Lemi0002/PIC32ETH_EL/README.md

# PIC32ETH_EL
Repository for PIC32ETH electronics. This board is a simple development board
to investigate what it actually takes to integrate ethernet connectivity into
its own PCB design.

## Tool configuration
The following software versions were used:

* Altium Designer: v20.1.1
