Lemi0002/PIC32ETH_EL/PIC32ETH/Project_Outputs/Bill_Of_Materials/Bill_Of_Materials.xlsx

Designator | Comment | Part Number | Description | Package | Quantity
C1, C2, C3, C4, C5, C6, C7, C8, C9, C10, C11, C12, C24, C25, C26, C27, C29, C33, C34, C35, C39, C42, C44, C49 | 100nF | C0805C104K5RACTU | C CERAMIC 100nF 50V 10% 2012 | 2012 | 24
C13, C14, C15, C19, C20, C21, C22, C28 | 10nF | C0805C103K5RACTU | C CERAMIC 10nF 50V 10% 2012 | 2012 | 8
C16, C18, C36, C37, C47, C48 | 1uF | C0805C105K5RACTU | C CERAMIC 1uF 50V 10% 2012 | 2012 | 6
C17, C38, C43 | 10uF | C1206C106K3RACTU | C CERAMIC 10uF 25V 10% 3216 | 3216 | 3
C23, C32 | 220nF | C0805C224K5RACTU | C CERAMIC 220nF 50V 10% 2012 | 2012 | 2
C30, C31 | 47pF | C0805C470K5GACTU | C CERAMIC 47pF 50V 10% 2012 | 2012 | 2
C40, C41, C45, C46, C50 | 22uF | C1206C226K8RAC7800 | C CERAMIC 22uF 10V 10% 3216 | 3216 | 5
C51 | 1nF | C0805C102K5RACTU | C CERAMIC 1nF 50V 10% 2012 | 2012 | 1
D1 | DRTR5V0U4S-7 | DRTR5V0U4S-7 | D TVS 5.5V 6V 200mW SOT-363 | SOT-363 | 1
D2, D3, D4, D5 | APT2012LZGCK | APT2012LZGCK | D LED GREEN CLEAR 2.65V 2mA 2012 | 2012 | 4
FB1, FB2, FB3, FB4, FB5 | 120R 100MHz | BLM31KN121SN1L | FB 120R 100MHz 6A 3216 | 3216 | 5
H1 | TSW-106-08-G-S-RA | TSW-106-08-G-S-RA | H GENERAL HEADER 6POS 1ROW 2.54mm ANGLE THT | n/a | 1
H2 | J3011G21DNL | J3011G21DNL | H RJ45 SOCKET 1PORT ANGLE SMT | n/a | 1
H3 | 897-43-005-00-100001 | 897-43-005-00-100001 | H USB SOCKET 1PORT B-MINI ANGLE SMT | n/a | 1
H4 | 76382-302LF | 76382-302LF | H GENERAL HEADER 2POS 1ROW 2.54mm ANGLE THT | n/a | 1
H5, H6 | SSW-105-01-G-D | SSW-105-01-G-D | H GENERAL SOCKET 10POS 2ROW 2.54mm VERTICAL THT | n/a | 2
H7 | TSW-103-08-G-S-RA | TSW-103-08-G-S-RA | H GENERAL HEADER 3POS 1ROW 2.54mm ANGLE THT | n/a | 1
L1, L2 | 4.7uH | LQM2HPN4R7MG0L | L CERAMIC 4.7uH 1.1A 138mR 2520 | 2520 | 2
Q1, Q2, Q3 | DMG1012UW-7 | DMG1012UW-7 | Q MOSFET N-CH 20V 1A SOT-323 | SOT-323 | 3
R1, R2, R3, R4, R5, R6, R7, R8, R9, R10, R11, R12, R13, R14, R15, R21, R22, R32, R56, R57, R58, R69 | 330R | RMCF0805FT330R | R SMT 330R 1% 125mW 2012 | 2012 | 22
R16, R17 | 4.7kR | RMCF0805FT4K70 | R SMT 4.7kR 1% 125mW 2012 | 2012 | 2
R18, R19, R20, R29, R30, R31, R39, R55, R59, R60, R61, R62, R65, R68 | 10kR | RMCF0805FT10K0 | R SMT 10kR 1% 125mW 2012 | 2012 | 14
R23, R24, R25, R26, R40, R41, R42, R45, R50, R51, R52, R53, R54 | 33R | RMCF0805FT33R0 | R SMT 33R 1% 125mW 2012 | 2012 | 13
R27, R28 | 1R | RMCF0805FT1R00 | R SMT 1R 1% 125mW 2012 | 2012 | 2
R33, R34, R44, R46, R47, R48 | 1kR | RMCF0805FT1K00 | R SMT 1kR 1% 125mW 2012 | 2012 | 6
R35, R36, R37, R38 | 49.9R | RMCF0805FT49R9 | R SMT 49.9R 1% 125mW 2012 | 2012 | 4
R43 | 18.7kR | RMCF0805FT18K7 | R SMT 18.7kR 1% 125mW 2012 | 2012 | 1
R49 | 1.91kR | RMCF0805FT1K91 | R SMT 1.91kR 1% 125mW 2012 | 2012 | 1
R63, R66 | 30R | RMCF0805FT30R0 | R SMT 30R 1% 125mW 2012 | 2012 | 2
R64 | 52.3kR | RMCF0805FT52K3 | R SMT 52.3kR 1% 125mW 2012 | 2012 | 1
R67 | 31.6kR | RMCF0805FT31K6 | R SMT 31.6kR 1% 125mW 2012 | 2012 | 1
R70 | 1.2kR | RMCF0805FT1K20 | R SMT 1.2kR 1% 125mW 2012 | 2012 | 1
S1, S2, S3 | PTS645SL50SMTR92 LFS | PTS645SL50SMTR92 LFS | S TACTILE SPST-NO 12V 50mA SMT | n/a | 3
TP1, TP2, TP3, TP4 | 5006 | 5006 | TP COMPACT BLACK THT | n/a | 4
U1 | PIC32MZ1024EFE144-I/PH | PIC32MZ1024EFE144-I/PH | U MCU 32BIT 1MB 144-TQFP | 144-TQFP | 1
U2 | ICS1894-33 | ICS1894-33 | U TRANSCEIVER RMII-ETHERNET 32-QFN | 32-QFN | 1
U3 | FT230XS-R | FT230XS-R | U TRANSCEIVER UART-USB 16-SSOP | 16-SSOP | 1
U4, U5 | TPS56339DDCR | TPS56339DDCR | U REGULATOR BUCK 0.8V TO 16V 3A SOT-23-6 | SOT-23-6 | 2
Y1 | 32.768kHz | ECS-327ATQMV-AS-TR | Y OSCILLATOR 32.768kHz CMOS SMT | n/a | 1
Y2 | 24MHz | ECS-3225MV-240-CN-TR | Y OSCILLATOR 24MHz HCMOS SMT | n/a | 1
Y3 | 50MHz | ECS-3225MV-500-BN-TR | Y OSCILLATOR 50MHz HCMOS SMT | n/a | 1
