Lemi0002/PIC32ETH_EL/PIC32ETH/Project_Outputs/Schematic_Prints/Schematic_Prints.PDF

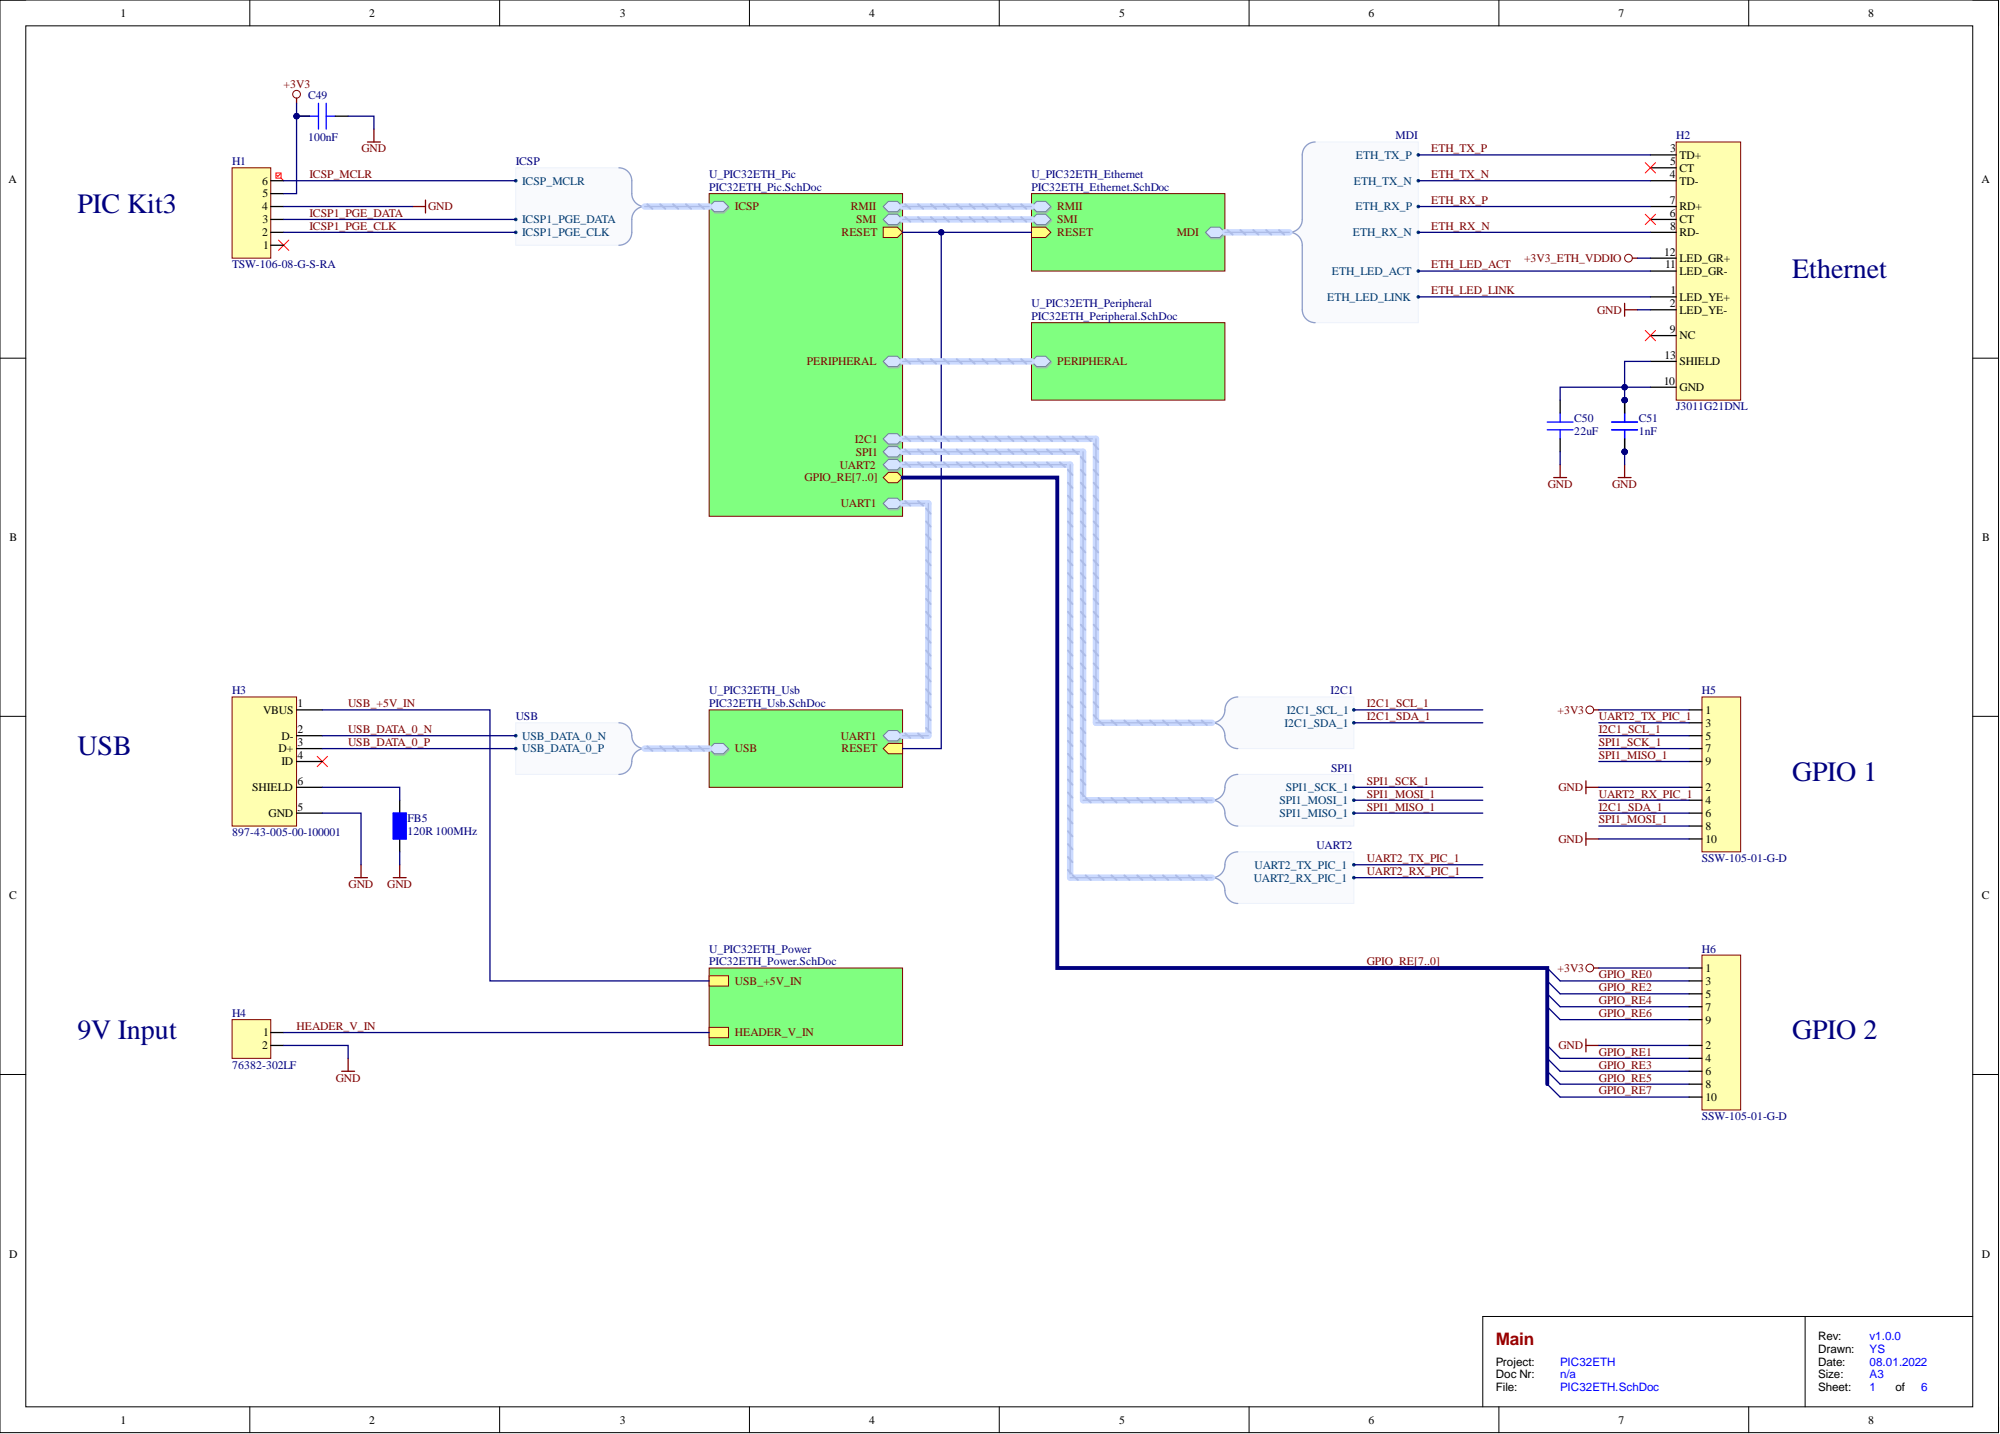
[picture p1: page 1]

Main Project: Doc Nr: File:

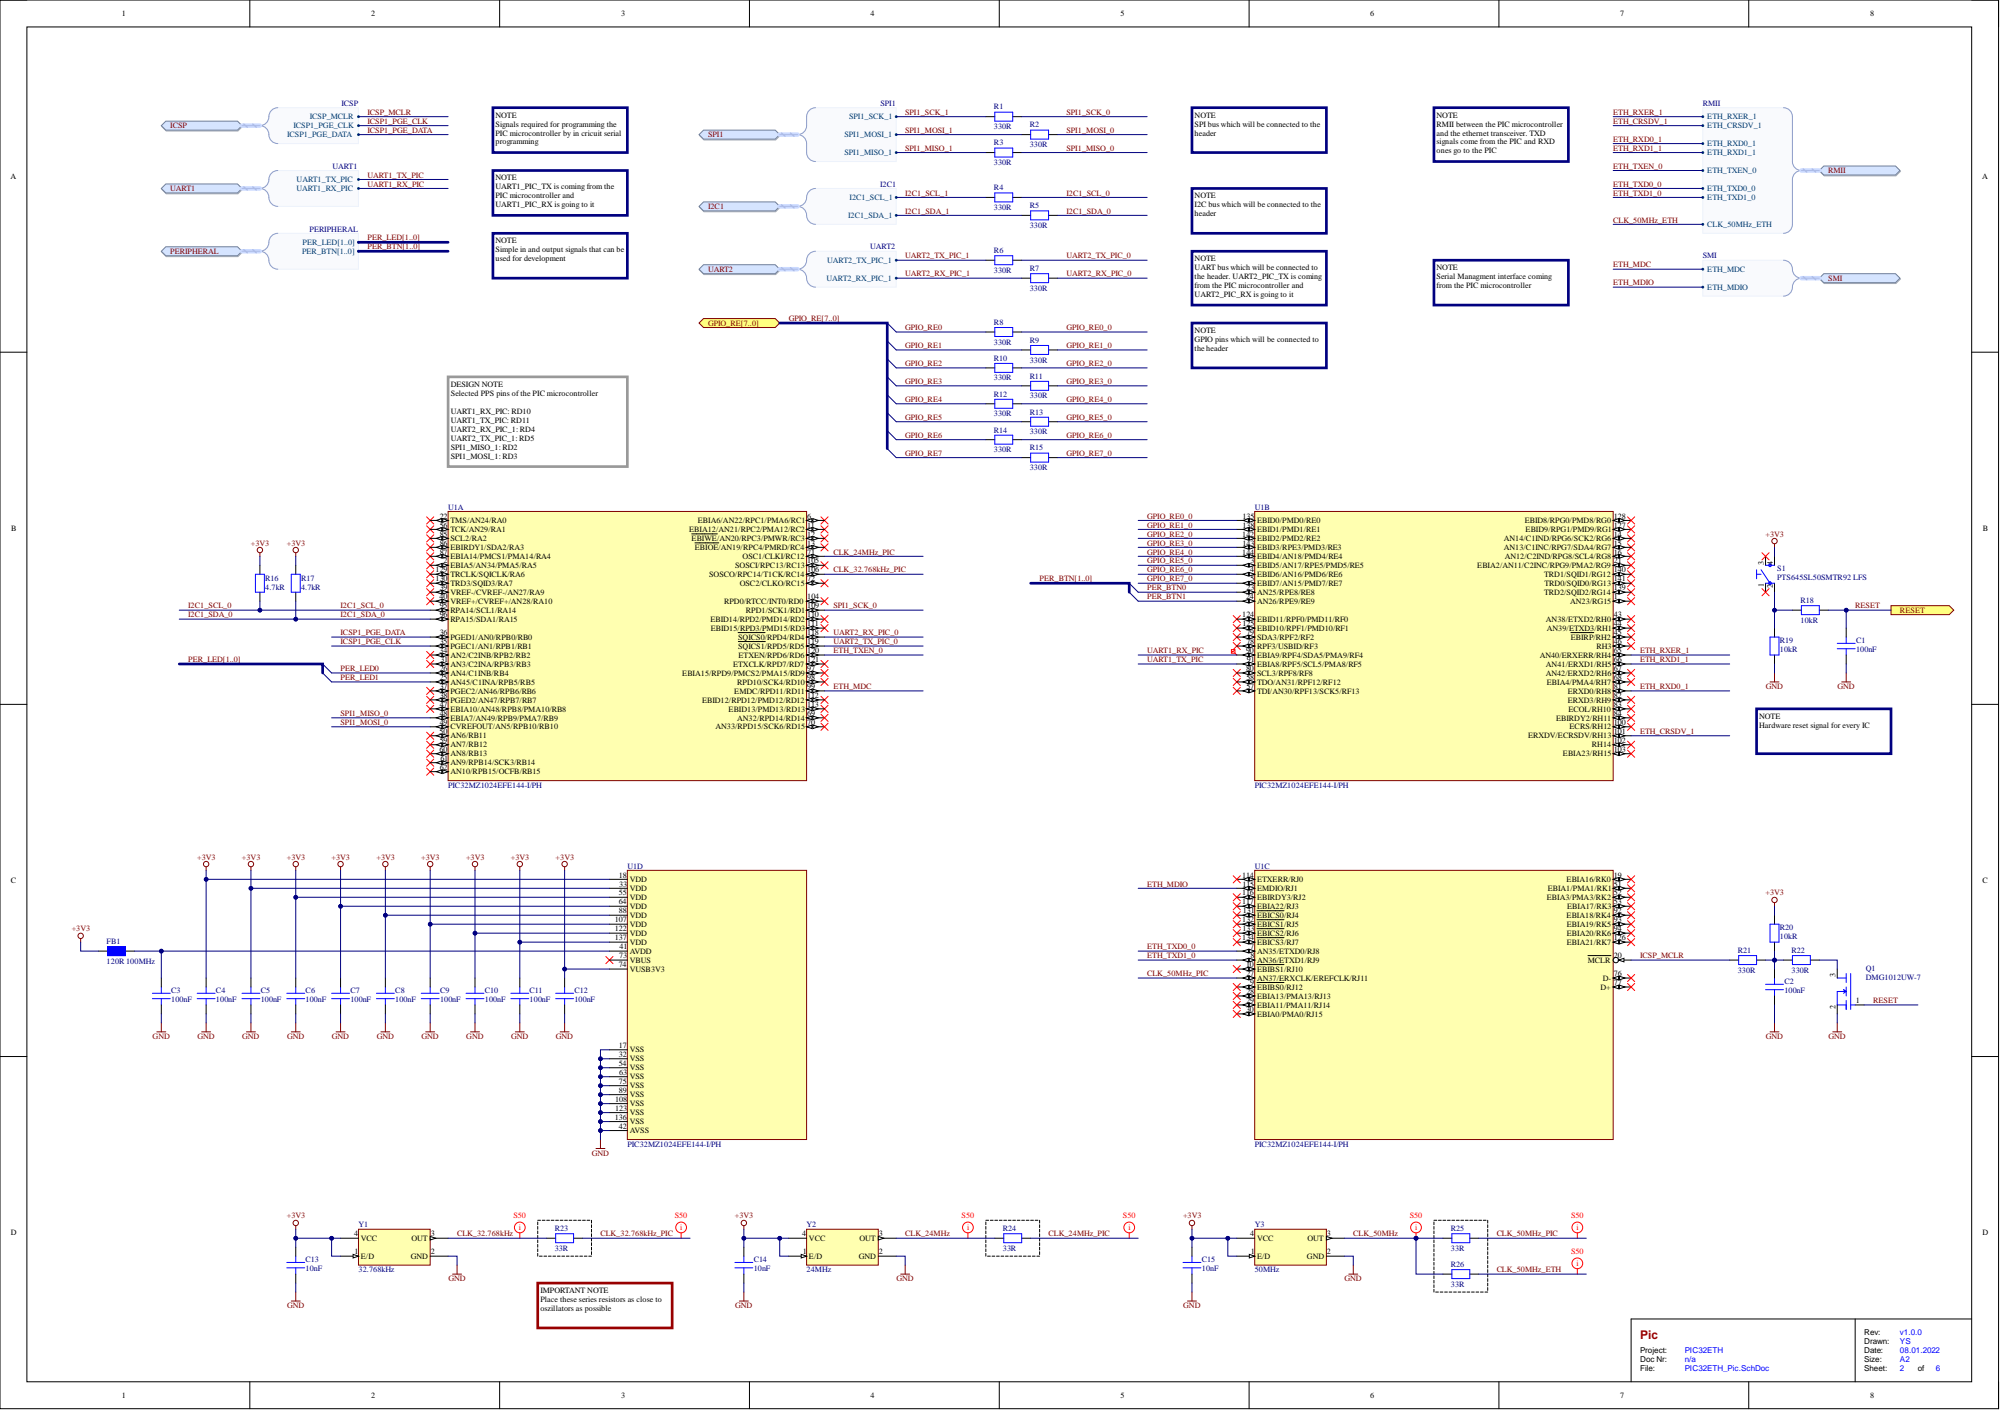
[picture p2: page 2]

NOTE
Signals required for programming the
PIC microcontroller by in cricuit serial
programming

SPI bus which will be connected to the
header

ETH_CRSDV_1 NOTE
RMII between the PIC microcontroller
and the ethernet transceiver. TXD
signals come from the PIC and RXD
ones go to the PIC

UART1_PIC_TX is coming from the
PIC microcontroller and
UART1_PIC_RX is going to it

I2C bus which will be connected to the

Simple in and output signals that can be
used for development

UART bus which will be connected to
the header. UART2_PIC_TX is coming
from the PIC microcontroller and
UART2_PIC_RX is going to it

Serial Managment interface coming

GPIO pins which will be connected to
the header

DESIGN NOTE
Selected PPS pins of the PIC microcontroller

Hardware reset signal for every IC

IMPORTANT NOTE
Place these series resistors as close to
oszillators as possible

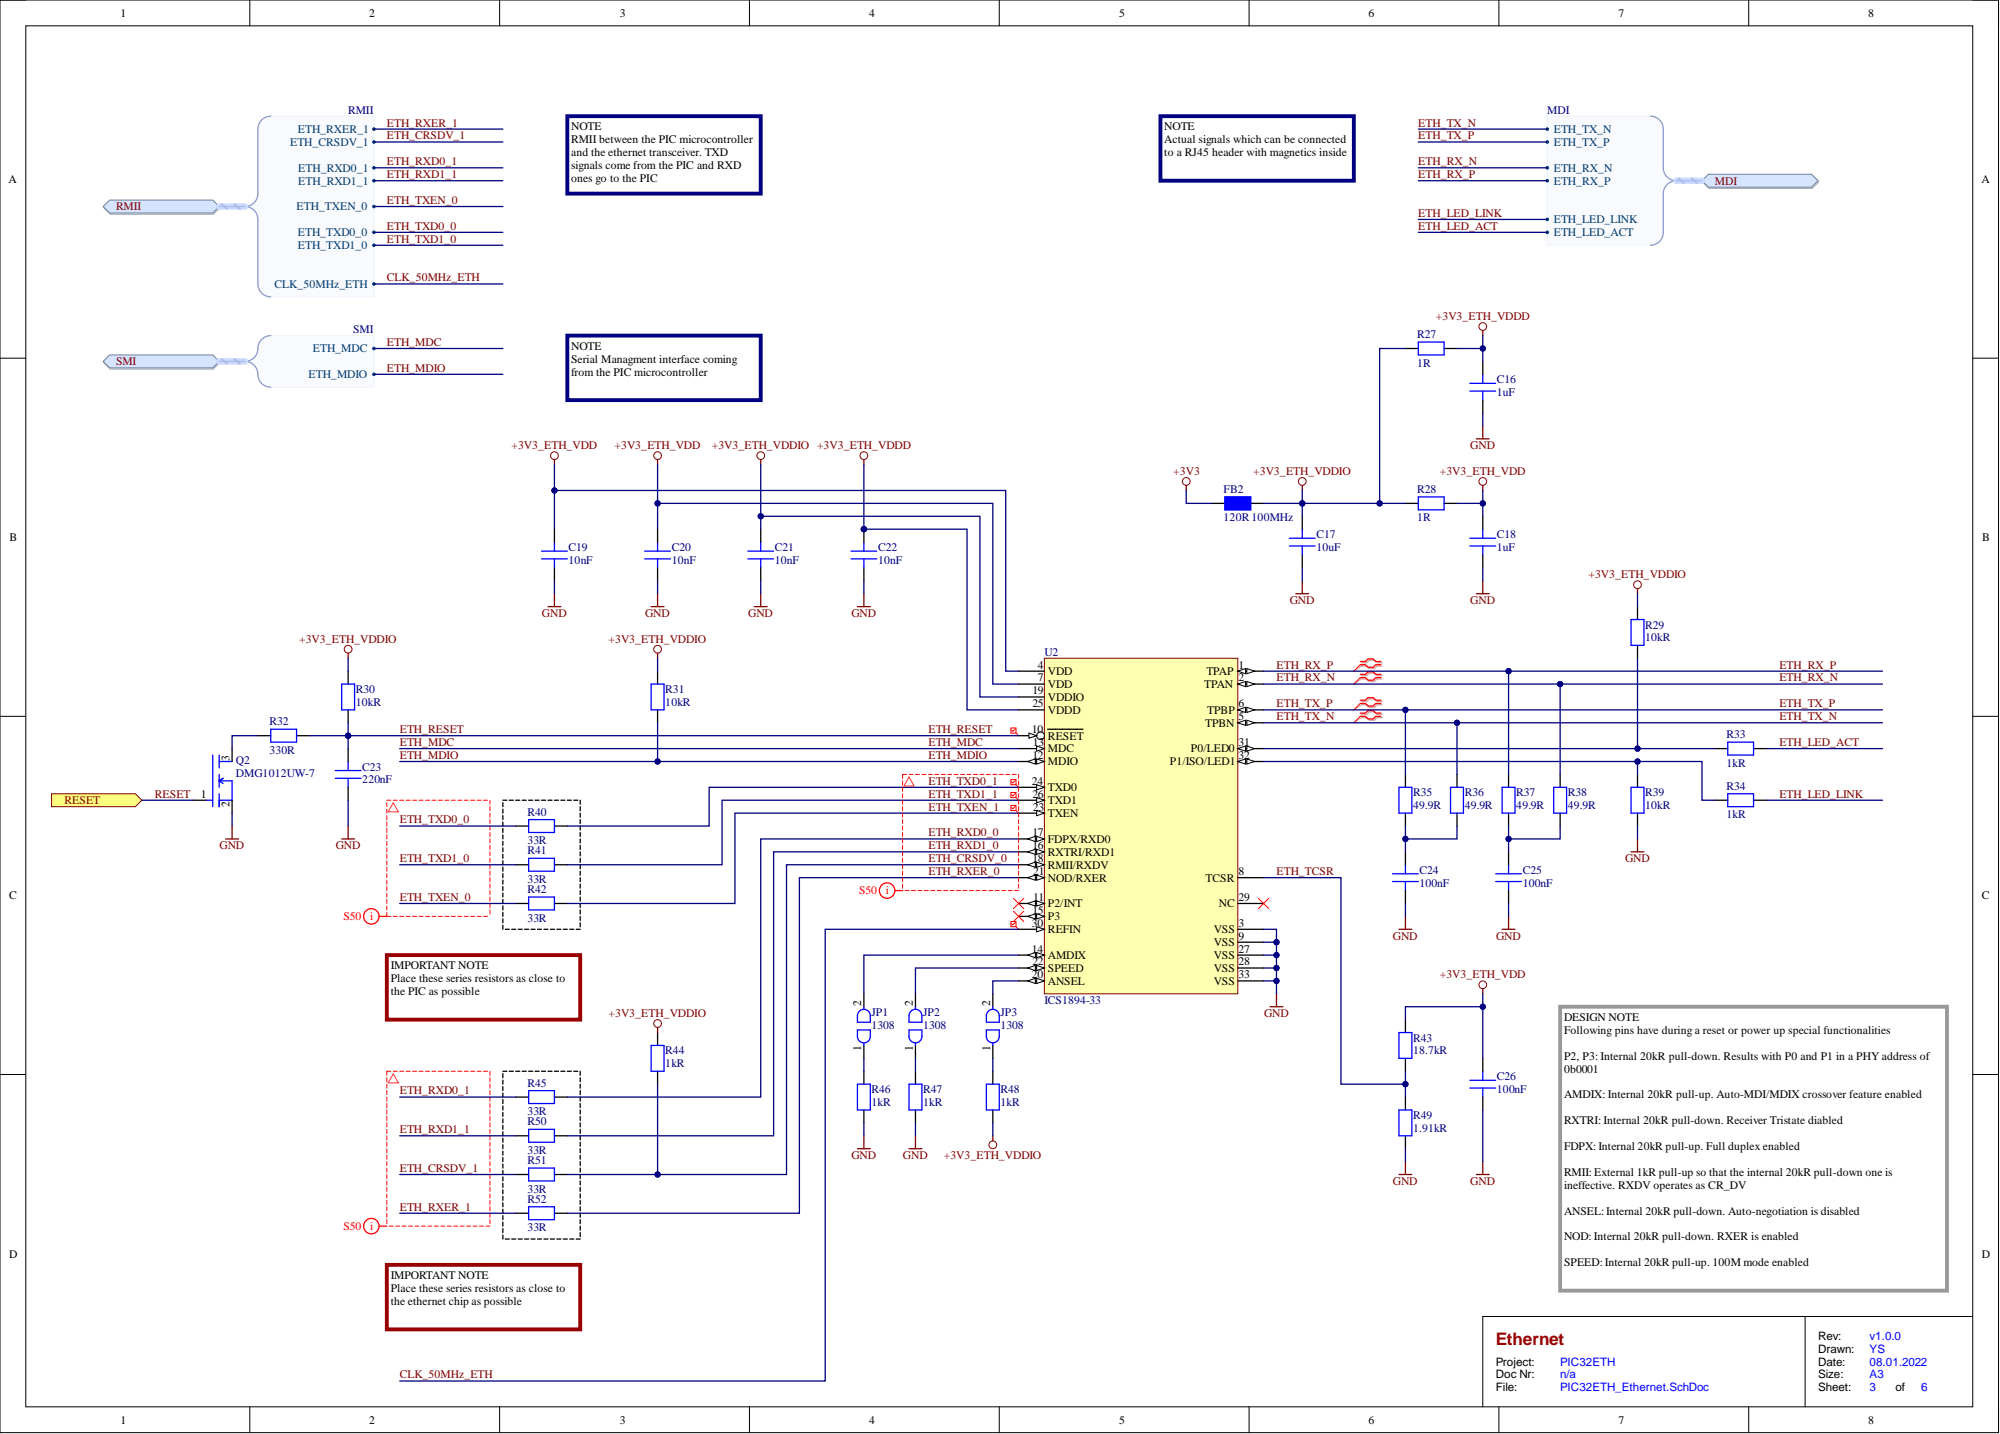
[picture p3: page 3]

ich can be co

1 9
2 5

E T H _CRSD V _ 0 | 1 8
E T H _RX ER_ 0 | 2 1

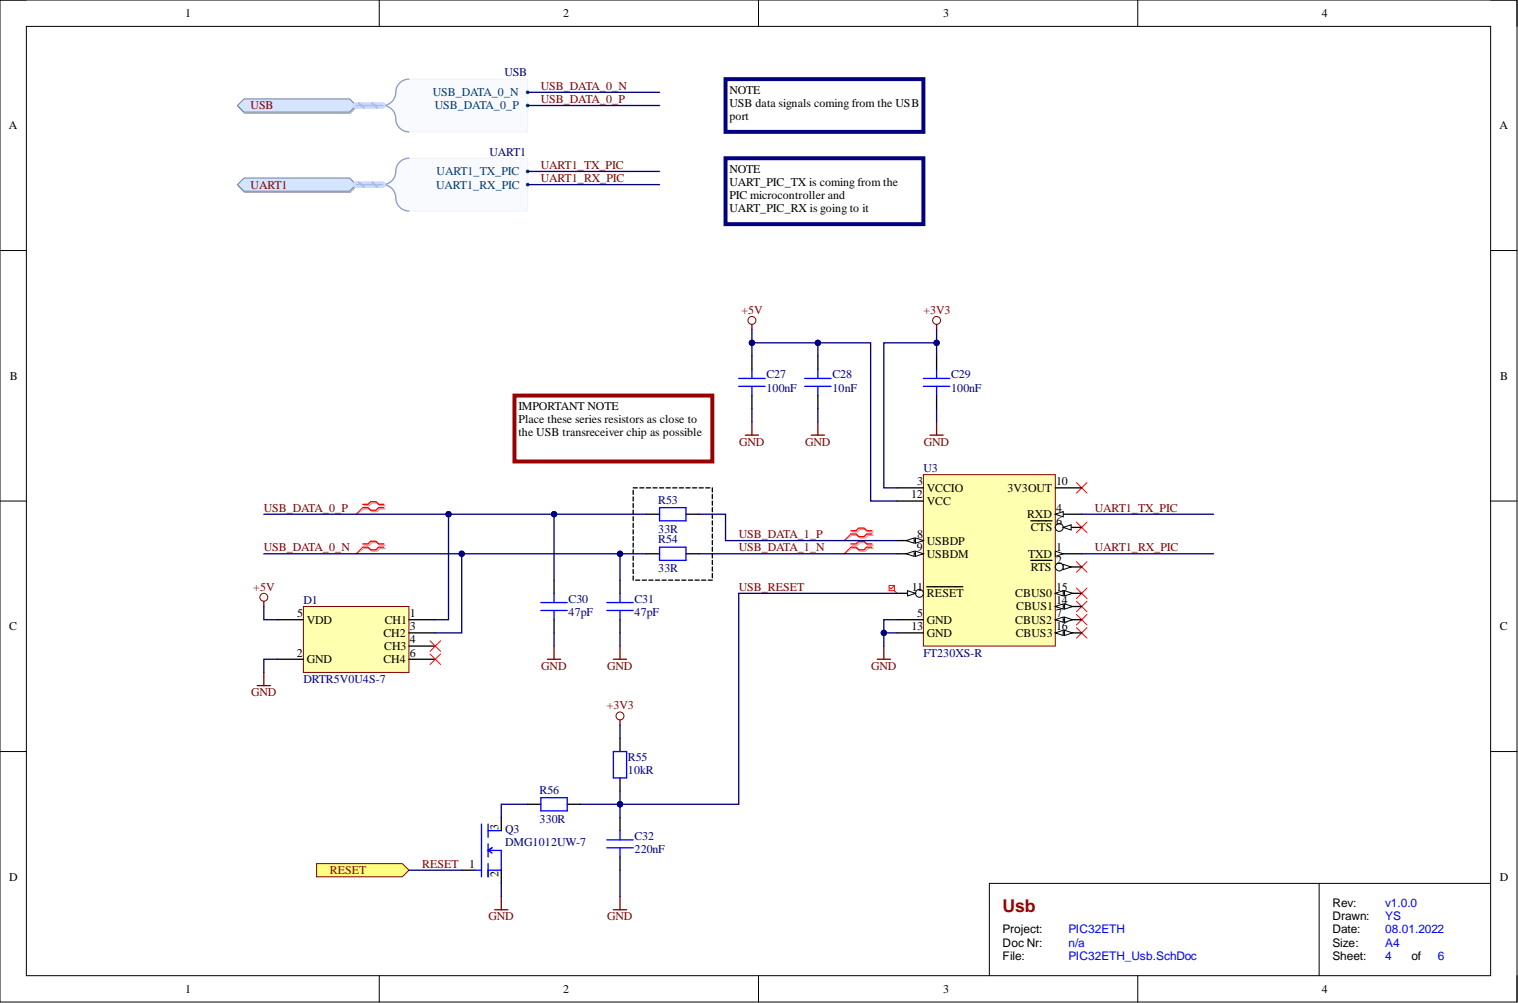
[picture p4: page 4]

NOTE
USB data signals coming from the USB
port

UART_PIC_TX is coming from the
PIC microcontroller and
UART_PIC_RX is going to it

IMPORTANT NOTE
Place these series resistors as close to
the USB transreceiver chip as possible

U3
VCCIO 3

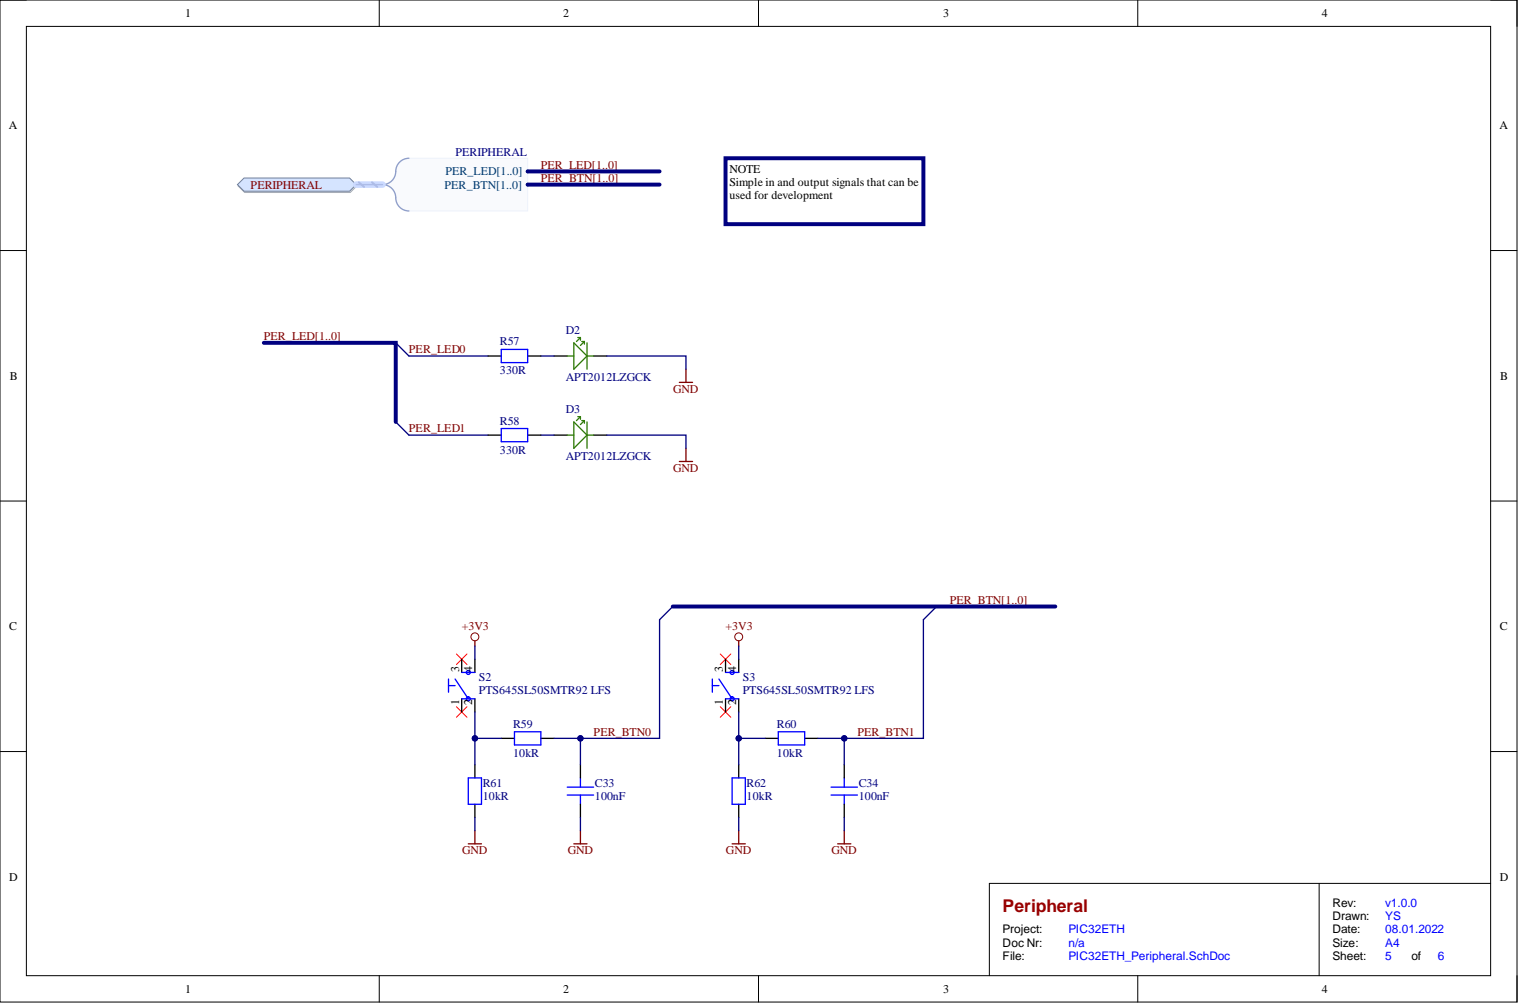
[picture p5: page 5]

NOTE
Simple in and output signals that can be
used for development

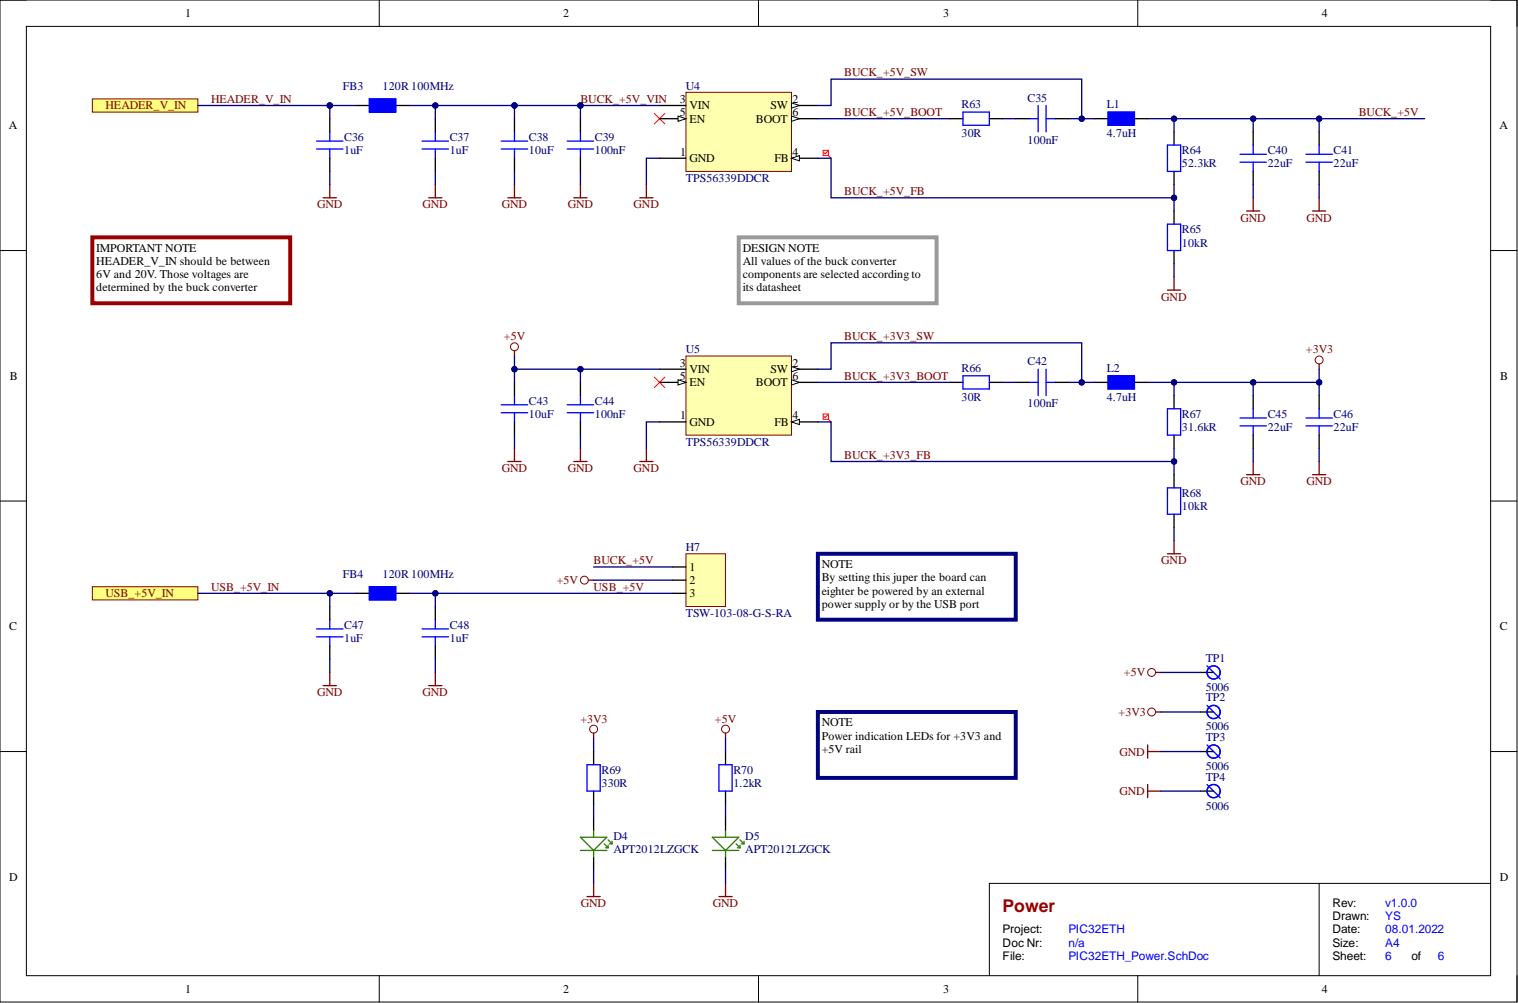
[picture p6: page 6]

IMPORTANT NOTE
HEADER_V_IN should be between
6V and 20V. Those voltages are
determined by the buck converter

DESIGN NOTE
All values of the buck converter
components are selected according to
its datasheet

By setting this juper the board can
eighter be powered by an external
power supply or by the USB port

NOTE
Power indication LEDs for +3V3 and
+5V rail
