Lemi0002/PIC32ETH_EL/PIC32ETH/Project_Outputs/Assembly_Drawings/Assembly_Drawings.PDF

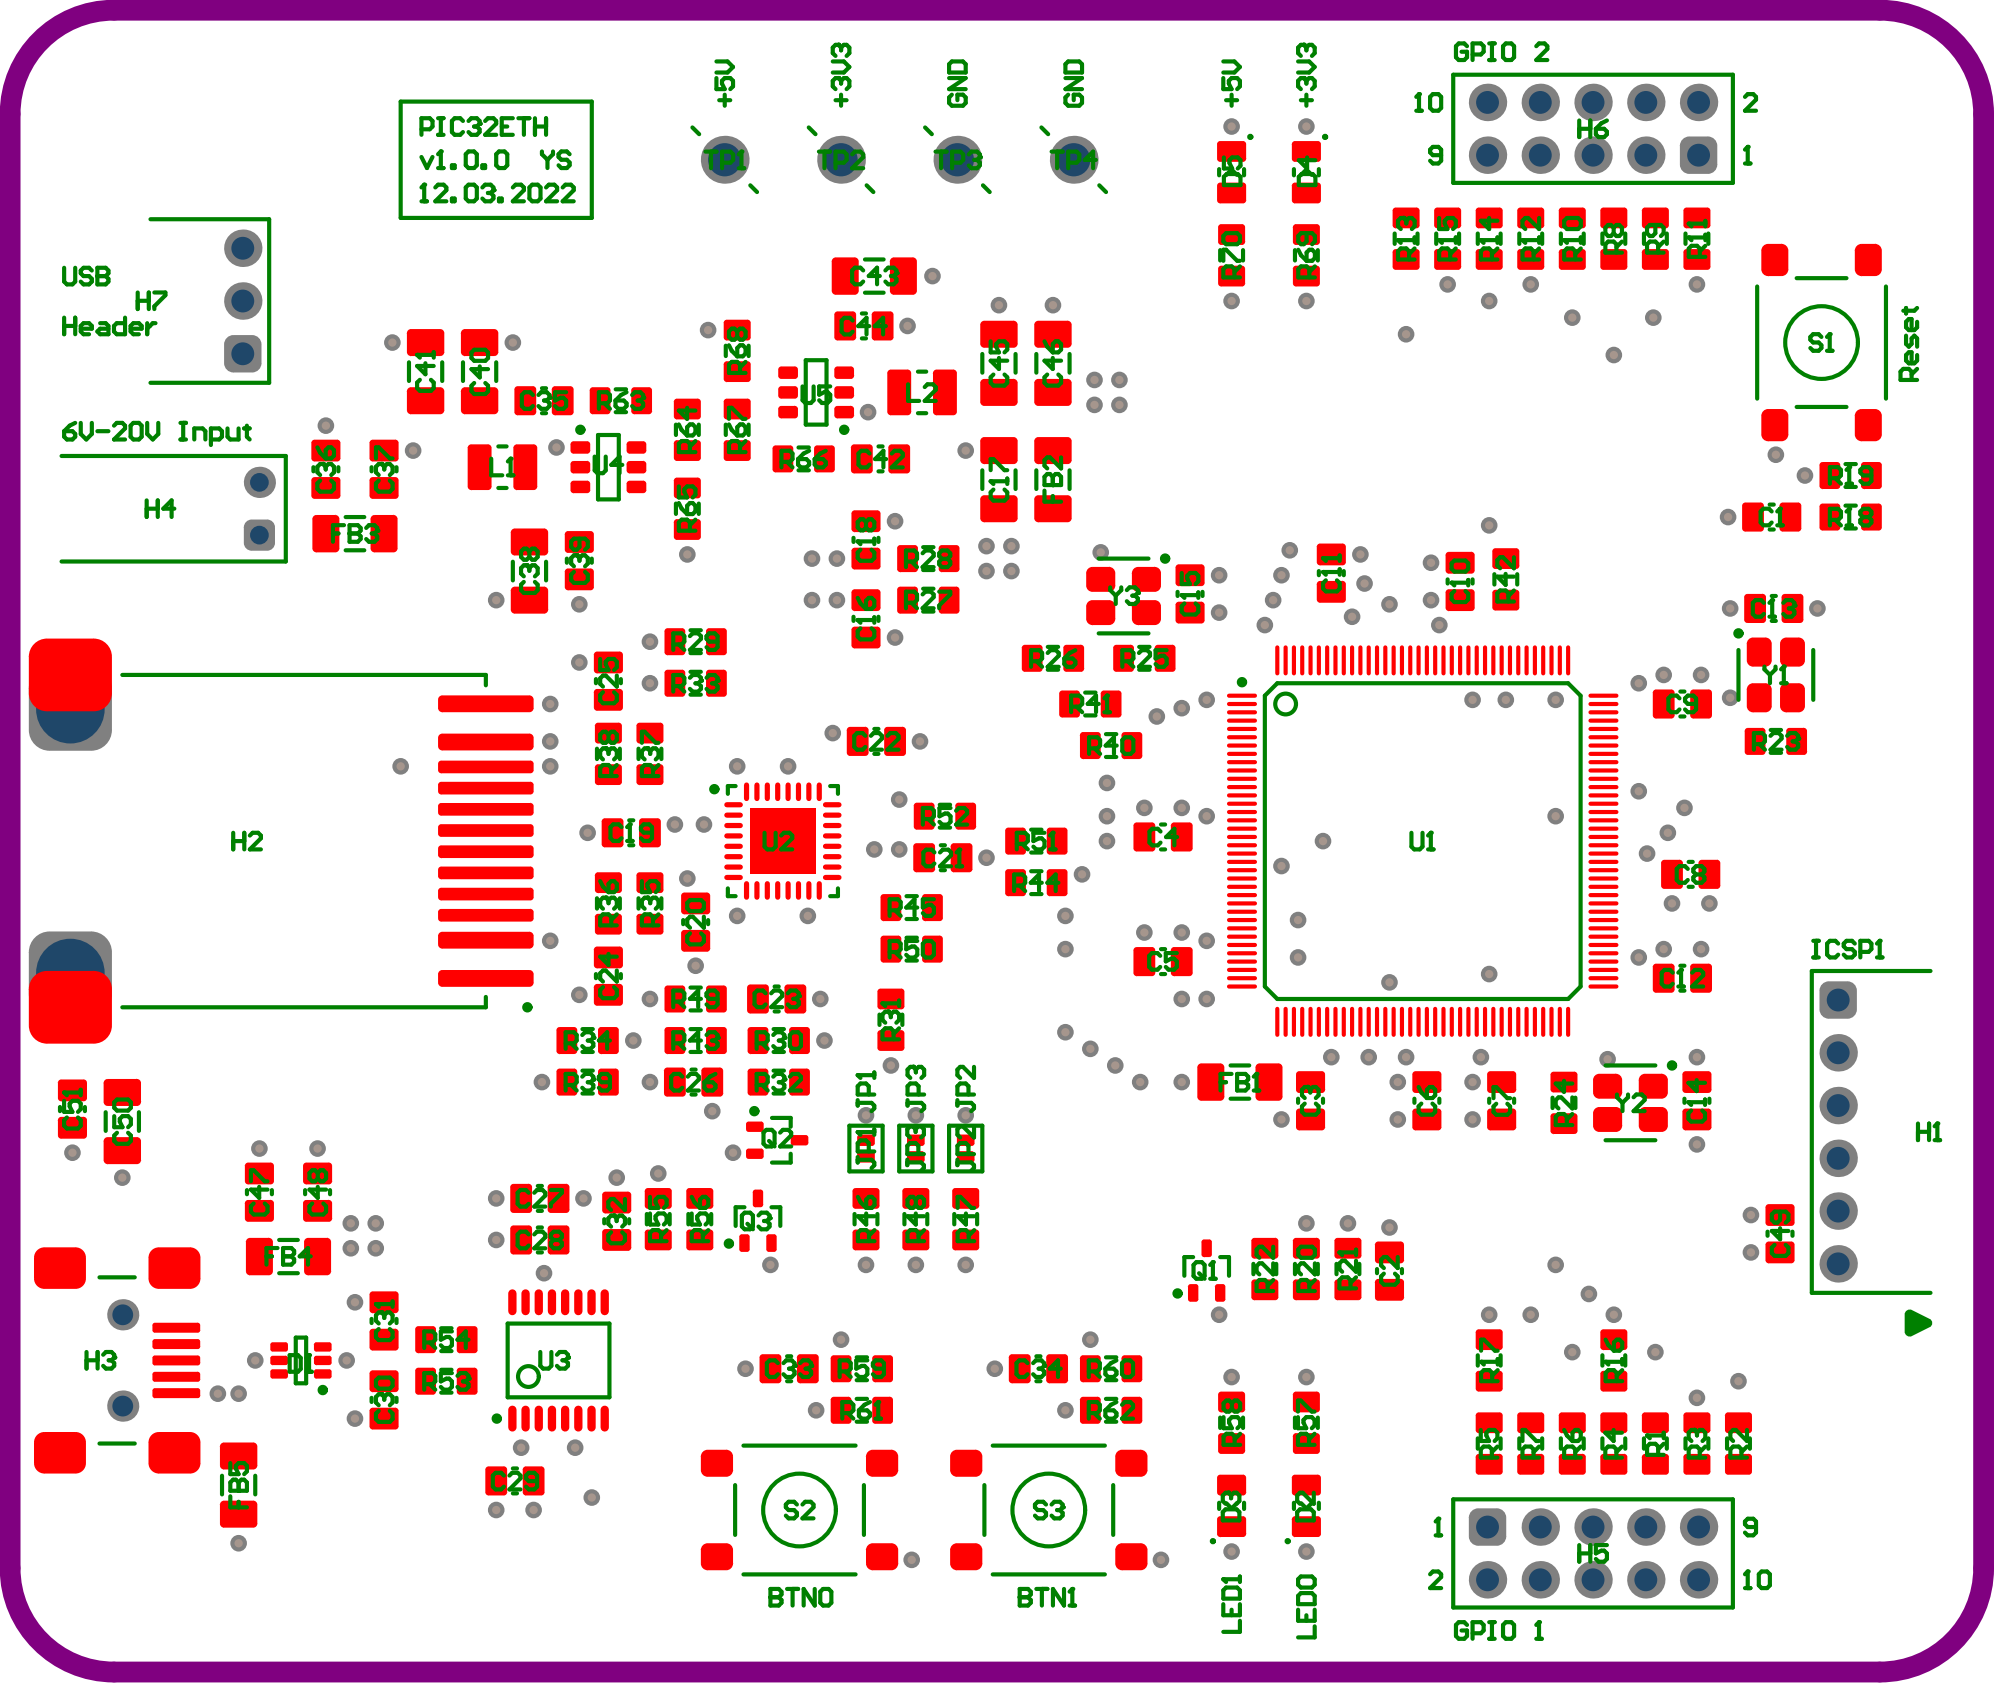
[picture p7: page 1]

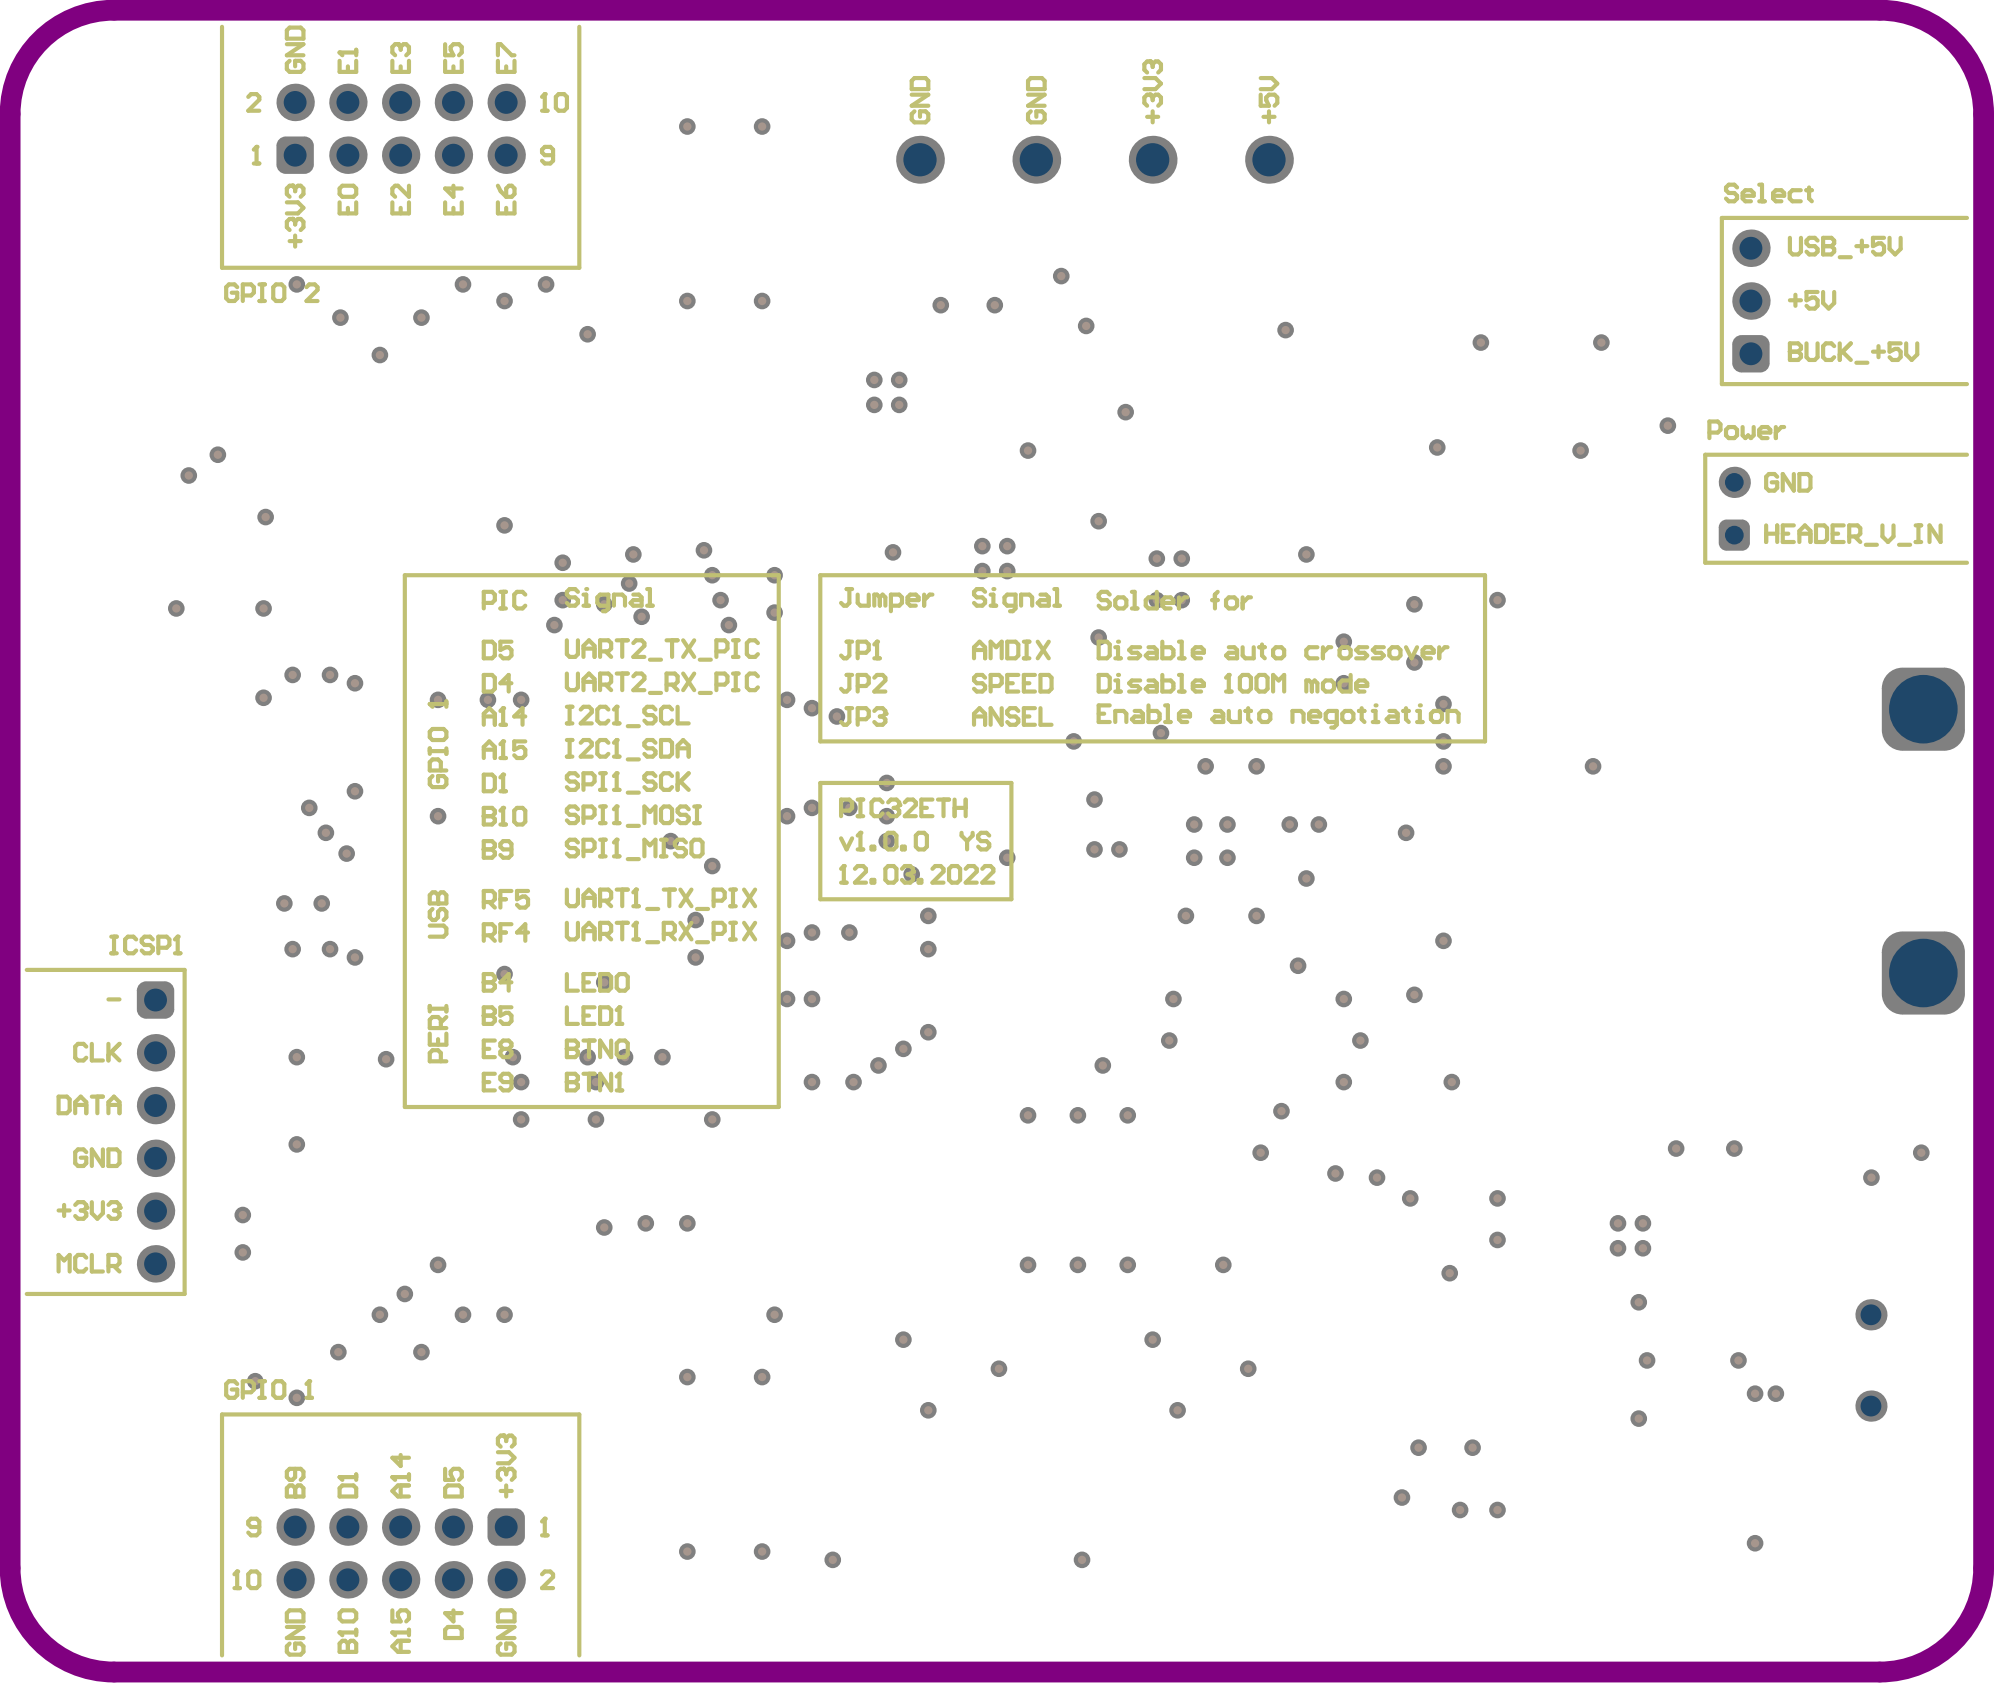
[picture p8: page 2]
