Lemi0002/PIC32ETH_EL/(list of files, drawings)

Other design files:
PIC32ETH/PIC32ETH.PcbDoc
PIC32ETH/PIC32ETH.PcbLib
PIC32ETH/PIC32ETH.PrjPcb
PIC32ETH/PIC32ETH.SchDoc
PIC32ETH/PIC32ETH.SchLib
PIC32ETH/PIC32ETH_Ethernet.SchDoc
PIC32ETH/PIC32ETH_Peripheral.SchDoc
PIC32ETH/PIC32ETH_Pic.SchDoc
PIC32ETH/PIC32ETH_Power.SchDoc
PIC32ETH/PIC32ETH_Usb.SchDoc
