Lemi0002/PIC32ETH_EL/(commit log)

2022-01-08 Started working on the project
    * Schematic sheets created
    * Started working on some of them
    [PIC32ETH.PrjPcb, PIC32ETH_Ethernet.SchDoc, PIC32ETH_Main.SchDoc, PIC32ETH_Peripheral.SchDoc, PIC32ETH_Pic.SchDoc, PIC32ETH_Power.SchDoc, PIC32ETH_Usb.SchDoc]
2022-01-17 Continued with the schematic
    * Continued working on different schematic pages
    [PIC32ETH.PrjPcb, PIC32ETH_Ethernet.SchDoc, PIC32ETH_Peripheral.SchDoc, PIC32ETH_Power.SchDoc, PIC32ETH_Usb.SchDoc]
2022-01-23 Continued with schematic
    * Worked on the main schematic page
    * The PIC schematic page is now the only incomplete one
    [PIC32ETH.PrjPcb, PIC32ETH_Main.SchDoc, PIC32ETH_Pic.SchDoc]
2022-01-24 Worked on schematic
    * Removed test points
    [PIC32ETH_Peripheral.SchDoc]
2022-01-26 Worked on schematic
    * Some work done in the PIC schematic
    [PIC32ETH_Ethernet.SchDoc, PIC32ETH_Pic.SchDoc]
2022-01-29 Schematic completed
    * Completed the whole schematic drawing
    * Optional ESD diodes are still missing
    [PIC32ETH.PrjPcb, PIC32ETH_Ethernet.SchDoc, PIC32ETH_Main.SchDoc, PIC32ETH_Peripheral.SchDoc, PIC32ETH_Pic.SchDoc, PIC32ETH_Power.SchDoc, PIC32ETH_Usb.SchDoc]
2022-01-30 PCB added
    * Added an PCB document to the project
    * Some components were not from the Altium_Libraries
    [PIC32ETH.PcbDoc, PIC32ETH.PrjPcb, PIC32ETH_Ethernet.SchDoc, PIC32ETH_Main.SchDoc, PIC32ETH_Peripheral.SchDoc, PIC32ETH_Pic.SchDoc, PIC32ETH_Power.SchDoc, PIC32ETH_Usb.SchDoc]
2022-02-04 Worked on schematic
    * Added series resistors to all pins of the PIC which are connected to the two pin headers
    * TVS protection diode added to the USB connector
    [PIC32ETH.PcbDoc, PIC32ETH.PrjPcb, PIC32ETH_Ethernet.SchDoc, PIC32ETH_Main.SchDoc, PIC32ETH_Peripheral.SchDoc, PIC32ETH_Pic.SchDoc, PIC32ETH_Power.SchDoc, PIC32ETH_Usb.SchDoc]
2022-02-05 Worked on layout
    * Started working on the layout
    * Components roughly placed in groups
    [PIC32ETH.PcbDoc]
2022-02-06 Worked on layout
    * Rearranged component clusters
    * Swapped RX and TX pairs at the ethernet driver
    [PIC32ETH.PcbDoc, PIC32ETH_Ethernet.SchDoc]
2022-02-07 Worked on layout
    * Continued roughly placing and routing the component clusters
    [PIC32ETH.PcbDoc]
2022-02-09 Worked on layout
    * Continued working on the layout
    [PIC32ETH.PcbDoc]
2022-02-09 Worked on layout
    * Continued with the ethernet and PIC layout parts
    [PIC32ETH.PcbDoc]
2022-02-10 Worked on layout
    * Worked on the power supply section
    [PIC32ETH.PcbDoc]
2022-02-11 Worked on layout
    * Added debouncing to the reset button
    * Worked on layout
    [PIC32ETH_Ethernet.SchDoc, PIC32ETH_Main.SchDoc, PIC32ETH_Peripheral.SchDoc, PIC32ETH_Pic.SchDoc, PIC32ETH_Power.SchDoc, PIC32ETH_Usb.SchDoc]
2022-02-13 Worked on layout
    * Reset signal vdd of the ethernet chip changed from the normal +3V3 to the +3V3_ETH_VDDIO rail
    * Worked on the power plain layout
    [PIC32ETH_Ethernet.SchDoc]
2022-02-14 Worked on layout
    * Moved component designators into a dedicated layer (M7 and M8 layer pair)
    [PIC32ETH.PrjPcb]
2022-02-14 File renamed
    * Renamed main schematic document
    [PIC32ETH.PrjPcb, PIC32ETH.SchDoc]
2022-02-14 Resistor edited
    * There were two types of 330R resistors in the design
    * Changed all to the RMC types
    [PIC32ETH.PrjPcb, PIC32ETH_Ethernet.SchDoc, PIC32ETH_Peripheral.SchDoc, PIC32ETH_Pic.SchDoc, PIC32ETH_Power.SchDoc, PIC32ETH_Usb.SchDoc]
2022-02-14 Changed component references
    * Changed all component references from the private libraries to the ones of the project
    [PIC32ETH.PcbLib, PIC32ETH.PrjPcb, PIC32ETH.SCHLIB, PIC32ETH.SchDoc, PIC32ETH_Ethernet.SchDoc, PIC32ETH_Peripheral.SchDoc, PIC32ETH_Pic.SchDoc, PIC32ETH_Power.SchDoc]
2022-02-14 Revert "Changed component references"
    This reverts commit c6f0e12b7020a451d2fabda38aa2d685c4ddb07b.
    [PIC32ETH.PcbLib, PIC32ETH.PrjPcb, PIC32ETH.SCHLIB, PIC32ETH.SchDoc, PIC32ETH_Ethernet.SchDoc, PIC32ETH_Peripheral.SchDoc, PIC32ETH_Pic.SchDoc, PIC32ETH_Power.SchDoc]
2022-02-14 Changed component references again
    * Because of some reason the previously generated library had upper case file endings
    [PIC32ETH.PcbLib, PIC32ETH.PrjPcb, PIC32ETH.SchDoc, PIC32ETH.SchLib, PIC32ETH_Ethernet.SchDoc, PIC32ETH_Peripheral.SchDoc, PIC32ETH_Pic.SchDoc, PIC32ETH_Power.SchDoc]
2022-02-15 Worked on PCB
    * Mainly worked on length matching and redrawing the differential pairs
    [PIC32ETH.PrjPcb, PIC32ETH.SchDoc, PIC32ETH_Ethernet.SchDoc, PIC32ETH_Peripheral.SchDoc, PIC32ETH_Pic.SchDoc, PIC32ETH_Power.SchDoc, PIC32ETH_Usb.SchDoc]
2022-02-15 Impedance controlled tracks added
    * All clock and MII interface signals are now 50R impedance controlled
    * Removed length matching because track widths couldn't be changed with a interactive length matching attacked to them
    [PIC32ETH_Ethernet.SchDoc, PIC32ETH_Pic.SchDoc]
2022-02-15 Worked on layout
    * RMII tracks length matched again
    * Reworked top and bottom tracks
    * Changed track width of power tracks
2022-03-05 PIC changed
    * Changed PIC to a 144-QFN package version
    * Checked pinout but nothing else
    [PIC32ETH_Pic.SchDoc]
2022-03-09 Worked on layout
    * Added new PIC to the project library
    * Rerouted PIC connections
    * Some RMII signals are currently routed on layer 4. Change them to layer 3. So that they are also referenced to the ground plane
    * Length matching and final touches must still be down
    [PIC32ETH.PcbLib, PIC32ETH.PrjPcb, PIC32ETH.SchDoc, PIC32ETH.SchLib, PIC32ETH_Ethernet.SchDoc, PIC32ETH_Peripheral.SchDoc, PIC32ETH_Pic.SchDoc, PIC32ETH_Power.SchDoc]
2022-03-10 Worked on schematic
    * Dismissed idea of changing the RMII tracks to layer 3
    * Edited power plane and retraced different tracks
2022-03-10 Worked on layout
    * Some silkscreen added
2022-03-12 Worked on layout
    * Silkscreen added
2022-03-12 Worked on layout
    * Did some final touches
    * Layout compiles successfully
    * Schematic and layout review must still be done
    [PIC32ETH.PrjPcb]
2022-03-26 Project reworked
    * Checked schematics and layout
    * ICSP data and clock signals were swapped
    [PIC32ETH.SchDoc, PIC32ETH_Ethernet.SchDoc, PIC32ETH_Peripheral.SchDoc, PIC32ETH_Pic.SchDoc, PIC32ETH_Power.SchDoc, PIC32ETH_Usb.SchDoc]
2022-04-02 Output generated
    * Generated manufacturing data
    * Thermal reliefs of the connector shields must be updated
    [Bill_Of_Materials.xlsx, Bill_Of_Materials_Order.xlsx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]
2022-04-09 Output generated
    * Redrawn and repoured polygons and planes
    [Bill_Of_Materials.xlsx, Bill_Of_Materials_Order.xlsx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]
2022-04-18 Updated resistor supplier number
    * Resistor supplier part number was misspelled
    [Bill_Of_Materials.xlsx, Bill_Of_Materials_Order.xlsx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]
2022-04-30 Assembly drawings updated
    * Top designator layer was missing
